eroxa090/SoilPlus2.0/public/soilplus-device.jpg

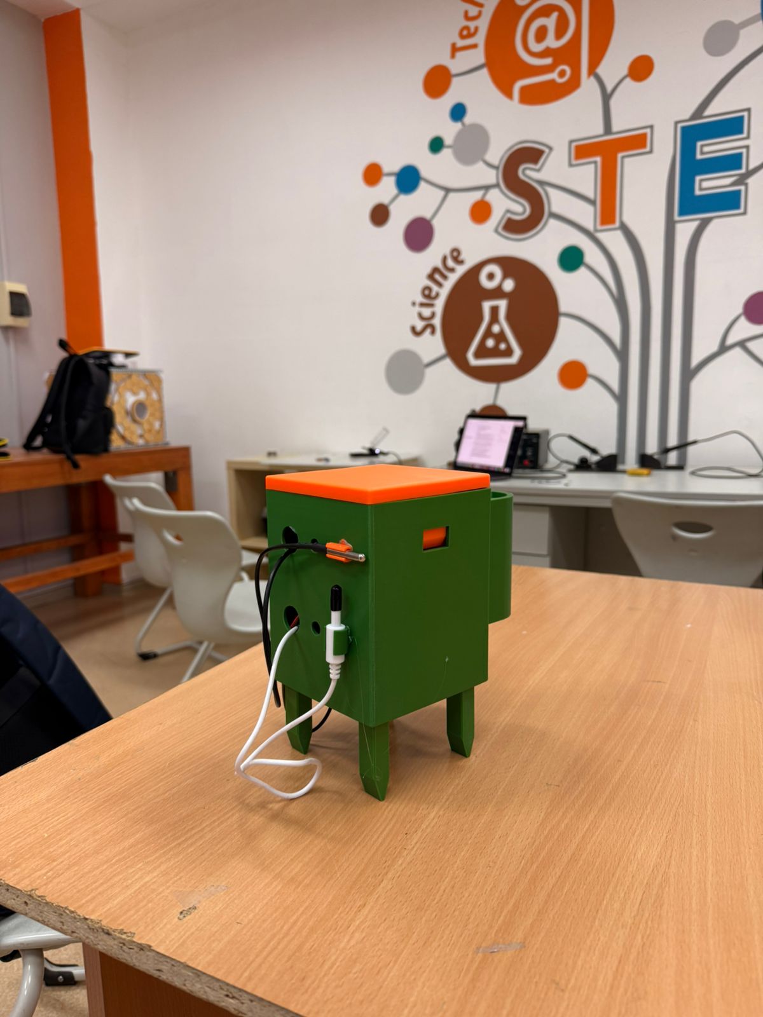
public/soilplus-device.jpg
