eroxa090/SoilPlus2.0/hardware/probe_mini/README.md

# SoilPlus Mini — короткий ручной щуп

Высота 27 см. Блок 95×95×48 мм, Т-ручка, горловина с юбкой-упором 120×70 мм.
Влажность уходит в почву на ~7 см, DS18B20 на 5 см, иглы TDS на 1.2 см. Электрод pH внешний, на разъёме BNC.

## Как запустить в Fusion

1. New Design → **Hybrid Design**, единицы mm.
2. UTILITIES → **Scripts and Add-Ins** → «+» → *Script or add-in from device* → папка `hardware/probe_mini/SoilPlusMini` → **Run**.
3. Результаты появятся в `hardware/probe_mini/out/`: STEP, STL, снимки и `fusion_report.json`.

Размеры — в блоке «ПАРАМЕТРЫ» и в функциях `build_*` файла `SoilPlusMini.py`.

## Детали для печати (PETG, слой 0.2, 6 периметров, без поддержек)

| Файл | Как класть на стол | Заполнение |
|---|---|---|
| 0_Test_Fit — тест пазов под перфоплату (печатать первым) | как есть | 25 % |
| 1_Body — блок | задней стенкой вниз, проём вверх | 25 % |
| 2_Lid — крышка | надписью вниз | 25 % |
| 3_Deck — панель | гладкой стороной вниз, направляющие вверх | 25 % |
| 10_Back_Frame — прижимная рамка | гладкой стороной вниз, упоры вверх | 30 % |
| 4_Handle — Т-ручка | боковой плоскостью вниз | 40 % |
| 5_Sensor_Head — горловина с юбкой | юбкой вниз | 30 % |
| 6_Blade_Guard — защитная вилка | плашмя | 100 % |
| 8a_Clamp_Center, 8b_Clamp_DS, 8c_Clamp_TDS — губки зажима | ровной стороной вниз | 100 % |
| 11_DS_Guard — мини-штатив DS18B20 | стоя, кольцом вниз, кайма 5 мм | 100 % |
| 12_Electrode_Cap_Holder — нижний держатель электрода (за колпачок) | стоя, основанием вниз | 100 % |
| 13_Electrode_Clip — верхняя клипса электрода | стоя, основанием вниз | 100 % |
| 7_Cap — колпачок | дном вниз | 15 % |
| 16_Plug_TypeC_Charge, 17_Plug_TypeC_ESP32 — заглушки Type-C | фланцем вниз | 100 % |

## Крепёж и инструмент

| Что | Кол-во | Куда |
|---|---|---|
| Винт M3×8 **с шестигранником (DIN 912)** | 8 | ручка (4), горловина (4), изнутри блока |
| Винт M3×10 | 12 | крышка (4), панель с рамкой (4), держатели электрода (4) |
| Винт M3×16 | 4 | губки зажима, сзади через отверстия горловины |
| Кусочки филамента 1.75 мм | 3 | штифт BMP280 (~3 см), центровка рамки (2 шт. по 4 мм) |

Латунных вставок нет: винты M3 вкручиваются прямо в пластик, в отверстия Ø2.5 (`PILOT_D`), и сами нарезают резьбу. Первый раз вкручивай медленно, до лёгкого упора, не перетягивай. Такая резьба выдерживает 3–5 разборок. Если отверстие разболталось, поставь винт на 2 мм длиннее или переходи на латунные вставки M3: тогда `PILOT_D = 4.0`.

Нужен Г-образный шестигранный ключ 2.5 мм: винты ручки и горловины стоят внутри блока, обычная отвёртка туда не войдёт. Для зажима — отвёртка с тонким стержнем (отверстия Ø7).

## Размеры

Зазор посадки везде 0.3 мм на сторону (`CLR` в начале скрипта). Исключения: зажимы, прижимы и штифты — они сделаны в натяг, иначе детали болтались бы.

| Деталь | Размер | Откуда |
|---|---|---|
| Плата pH | 41 × 32, с BNC 61 | замер |
| Электрод pH | Ø18.5, колпачок Ø21.5 × 51.5, длина 185 | замер |
| Плата TDS / щуп | 42 × 32 / корпус 44, иглы 6, кабель Ø3.5 | замер |
| Диаметр щупа TDS | ~12, губка на шарнире зажмёт Ø11.7–13.2 | в паспорте нет |
| DS18B20 | Ø6 × 51, кабель Ø4 | замер |
| Датчик влажности | 98.5 × 23 × 1, детали 9 | замер |
| ESP32 | 52 × 28, Type-C выступает 1.5, ряды 25.4 | замер / DevKit 30 pin |
| TP4056 | 28.5 с Type-C | замер |
| MT3608 | 37 × 17.5 × 6.5 | замер |
| BMP280 | 15 × 11 | замер |
| Аккумулятор 103450 | 52 × 34.5 × 10 с платой защиты | продавцы |
| Тумблер KCD1 2 pin | корпус 19 × 13 | продавцы |
| Перфоплата | 50 × 70 | стандарт 5×7 см |
| Пазы под платы (перфоплата, pH, TDS) | 1.8 (`PCB_SLOT`) | тест 0_Test_Fit: туго в 1.7, в 1.8+ болтается; в панели паз лежит поперёк слоёв, 1.8 = 9 слоёв |

Если реальная деталь отличается — поменять число в начале `SoilPlusMini.py` (`BAT_L`, `BAT_W`, `TDS_D`, `BNC_Z`, `BNC_Y`, `ELECTRODE_*`) и запустить скрипт заново.

## Как что закреплено

| Что | Чем держится |
|---|---|
| Ручка | 4 винта M3×8 изнутри блока у боковых стенок, в отверстия в широком основании ручки |
| Горловина | 4 винта M3×8 изнутри блока вниз, в отверстия в колоннах. Штырёк-ключ не даст поставить её наоборот |
| Крышка | 4 винта M3×10 через ушки. Рёбра жёсткости изнутри. Выступ BNC не даст закрыть её перевёрнутой |
| Панель и рамка | 4 винта M3×10 на 4 стойки; 2 штифта из филамента держат рамку на панели при сборке |
| pH-4502C, TDS | Едут в пазах панели до центрального упора; снаружи запирает стенка корпуса |
| Перфоплата с ESP32 | Едет в пазах до упора; запирает стойка на крышке. ESP32 прижимает подушка на крышке |
| TP4056, MT3608 | В гнёздах с упорами на задней стенке; прижаты по кромке упорами рамки |
| Аккумулятор | В гнезде с вырезом под провода слева; прижат двумя пружинящими лапками рамки |
| Тумблер KCD1 | Защёлкивается в окно стенки своими лапками |
| BMP280 | В пазах кармана до упора; снизу запирает штифт из филамента |
| Электрод pH (Ø18.5, колпачок Ø21.5) | Колпачок стоит на юбке в нижнем держателе на горловине, корпус защёлкивается в верхнюю клипсу на задней стенке блока |

Клей и скотч нигде не нужны.

## Датчики в горловине

Подвижная половина зажима разделена на 3 губки со своими винтами, поэтому каждая прижимает свой датчик.

- **Влажность:** плата заперта внутри вилки: снизу перемычка, сверху зубья. Плату ничего не сжимает.
- **Вилка:** её ушки лежат на дне и зажаты центральной губкой, винты проходят сквозь ушки.
- **DS18B20:** гильза в мини-штативе, буртик штатива между дном и зажимом, кабель зажат левой губкой.
- **Щуп TDS:** зажат за корпус правой губкой (шарнир + 1 винт).

## Порядок сборки

1. Напечатать 0_Test_Fit, проверить пазы под перфоплату.
2. Вставить плату влажности в вилку (электронику покрыть лаком), вилку опустить сверху в щель дна.
3. DS18B20 вставить в штатив кабелем вперёд, штатив опустить сверху в отверстие дна. Щуп TDS сверху (низ корпуса вровень с дном).
4. Поставить 3 губки зажима, затянуть 4 винта M3×16 через отверстия сзади.
5. Кабели DS18B20 и TDS укоротить до ~25 см и обжать в JST.
6. Блок, пока внутри пусто: привинтить ручку и горловину ключом изнутри (протянуть кабели в отверстие дна).
7. Задний ярус: MT3608 выставить на 5.0 В, поставить MT3608, TP4056, аккумулятор, тумблер. Провода к панели — через JST, пометить разъёмы.
8. На панель: pH справа и TDS слева в пазы до центрального упора. ESP32 паять на перфоплату по реальной сетке, Type-C к левому краю, перфоплату задвинуть справа до упора.
9. Рамку совместить с панелью штифтами, опустить в блок (BNC входит в паз справа), затянуть 4 винта. BMP280 вставить снизу в карман, запереть штифтом.
10. Подключить разъёмы, закрыть крышку на 4 винта.

**Прошивка:** кнопки EN и BOOT на ESP32 нажимаются зубочисткой через две прорези на крышке у левого края.
**BNC:** заглушку для разъёма лучше купить готовую (защитный колпачок BNC).

 ножом или отвёрткой сделать щель и отверстие под DS18B20, поставить щуп до упора юбкой, прижать землю вокруг.
Сила упирается в ручку и юбку: не качай прибор, когда он в земле.
Датчик влажности калибровать уже в собранном виде: `cal moistdry` / `cal moistwet`.
