eroxa090/SoilPlus2.0/hardware/probe/README.md

# SoilPlus — ручной щуп (модель для Fusion)

## Как запустить

1. Fusion → **Shift+S** (Scripts and Add-Ins).
2. Нажать **«+»** → *Script or add-in from device* → выбрать папку `hardware/probe/SoilPlusProbe`.
3. Выбрать **SoilPlusProbe** → **Run**. Скрипт работает 2–5 минут и откроет новый документ.
4. В конце появится окно с числом ошибок и пересечений. Результаты лежат в `hardware/probe/out/`:
   - `SoilPlus_Probe.step` — вся сборка;
   - `*.stl` — детали для печати;
   - `*.png` — снимки;
   - `fusion_report.json` — отчёт.

Если macOS спросит, можно ли Fusion писать в папку «Рабочий стол», — разрешить.

Размеры меняются в начале `SoilPlusProbe.py` (блок «ПАРАМЕТРЫ») → снова Run.

## Детали для печати (PETG, слой 0.2, 6 периметров)

| Деталь | Как класть на стол | Заполнение | Поддержки |
|---|---|---|---|
| 0_Test_Fit — тест вставок и трубы | как есть | 25 % | нет |
| 1_Head_Shell — корпус блока | дном (где окна портов) вниз | 25 % | tree, авто |
| 2_Head_Lid — крышка | надписью вниз | 25 % | нет |
| 3_Stirrup_Front / Back — стремя | плоскостью разреза вниз (176×176) | **40 %** | нет |
| 4_Nose — наконечник | шейкой вниз, остриём вверх, кайма 5 мм | **40 %** | нет |
| 6_Handle_Front / Back — Т-ручка | плоскостью разреза вниз | 30 % | нет |
| 7_Tube_Clamp — обойма | ровной задней стороной вниз (желоб вверх) | 30 % | нет |
| 8_Mount_Plate — монтажная плата | стоя на нижнем торце, кайма 5 мм | 25 % | tree, авто |

Стремя и наконечник — 40 %: на них давят ногой.

## Купить

| Что | Кол-во |
|---|---|
| Труба алюминиевая 25×2 мм, 770 мм (или ПВХ 25) | 1 |
| Полоса алюминиевая 40×4 мм, 118 мм (ступенька) | 1 |
| Вставки латунные M3 (отв. Ø4.0, длина ≤ 8) | 23 |
| Винт M3×16 | 15 |
| Винт M3×10 (крышка) | 4 |
| Винт M3×8 (монтажная плата) | 4 |
| Винт M3×40 + гайка (наконечник) | 1 |
| Винт M3×45 + гайка (стремя и ручка к трубе) | 2 |
| Шнур уплотнительный Ø2 | 50 см |
| Трубка силиконовая 6×8 мм | ~1.5 м (от насоса до наконечника) |

## Сверлить трубу

- Ø3.4 поперёк трубы: в 43 мм от нижнего конца и в 22 мм от верхнего.
- Ø10 со стороны крышки блока: в 568 мм от нижнего конца. Через это отверстие провода выходят в блок, поставить резиновую втулку.

## Как идут вода и провода

Трубка 6×8 заходит в отверстие на верху Т-ручки, идёт внутри штанги и через канал в правой ноге стремени попадает в наконечник. Вода выходит на скосе острия, ниже датчиков.
Провода датчиков идут тем же путём вверх и выходят в блок через отверстие Ø10.

## Что проверить, когда придут детали

- ESP32: разъём Type-C должен стоять на нижнем краю перфоплаты, иначе он не попадёт в окно дна.
- pH-4502C: BNC внизу платы, по центру. Если стоит иначе — сдвинуть окно (`bnc` в `build_shell`).
- Щуп TDS: диаметр Ø12 и длина корпуса ~45 мм взяты на глаз.
- Датчик влажности v1.2 закрыт стенкой 0.8 мм. После сборки откалибровать прямо в корпусе: `cal moistdry` / `cal moistwet`.
