eroxa090/SoilPlus2.0/hardware/enclosure/viewer_template.html

# SoilPlus колышек

Голова с выдвижным двухъярусным лотком, ствол из двух половин и игла для глубокого полива. Серым и цветным показаны макеты модулей: по ним проверены зазоры.

голова 132×98×64 мм

глубина 10 см

деталей 6

стол ≤180 мм

поддержки нет

Загружаю модель…

Собрано Разнесено Лоток выдвинут Сквозь корпус

Модули Почва Разрез

Вращать — левой кнопкой или пальцем, двигать — правой, масштаб — колесом. Наведи на деталь, чтобы увидеть название.

## Печать — 6 деталей, PETG

Слой 0.2, стенки 6 периметров (2.4 мм), заполнение 25–30 %. Все детали без поддержек, если класть их так, как написано серым.

## Крепёж

Вставки M3 (отв. Ø4.0, глуб. 6) | 16 шт
M3×8, полукруглая головкапередняя панель → фланец головы | 4 шт
M3×8, потайпалуба → стойки лотка | 4 шт
M3×6, потайколышек → голова, изнутри | 4 шт
M3×16, любая головкаполовины колышка | 4 шт
Штифт Ø3×8 (гвоздь, пруток)центровка половин колышка | 3 шт
Шнур уплотнителя Ø2канавка на панели, П-образно | ~30 см

Потайные M3 и шнур Ø2 добавь в список покупок, если их нет.

## Сборка

1. Вплавь все вставки паяльником (~220 °C) до установки электроники.
2. Колышек: датчик влажности (электронику покрыть лаком) в щель, DS18B20 и щуп TDS в отверстия дна, иглу с трубкой в гнездо. Кабели вверх. Закрой половины, 4 винта, низ промажь силиконом.
3. Прикрути колышек к голове: 4 потайных винта изнутри.
4. Ярус 1 на столе: аккумулятор на стяжку, TP4056, тумблер в панель, два MT3608 (сначала выставь 5.0 В), D4184, конденсатор.
5. Палуба: перфоплата с ESP32 въезжает сзади в направляющие до упора. pH-плата — BNC в отверстие панели. TDS-плата сзади справа. Провода через прорези, палубу на 4 винта.
6. В кабельном отсеке подключи JST датчиков и BMP280, задвинь лоток, затяни 4 винта панели.

## Размеры взяты типовые — проверь, когда придут детали

- ESP32 51.5×28.5: разъём Type-C должен оказаться на переднем краю перфоплаты, иначе он не совпадёт с окном панели. Гребёнки паяй так, чтобы плата ESP32 выступала вперёд на ~0.7 мм.
- D4184 заложен самый большой вариант (35×16). Если придёт маленький (23×16), он просто встанет в гнездо с запасом.
- Тумблер KCD1: вырез 19.2×13.2. Бывают 21×15 — тогда поменяй одно число в скрипте.
- Щуп TDS: диаметр в паспортах не указан, заложено Ø12. Если другой, меняется одно число.
- Трубка 6×8 мм под ёлочку иглы. Сначала купи насос, потом трубку под его штуцер.
