eroxa090/SoilPlus2.0/hardware/probe/out/1_iso.png

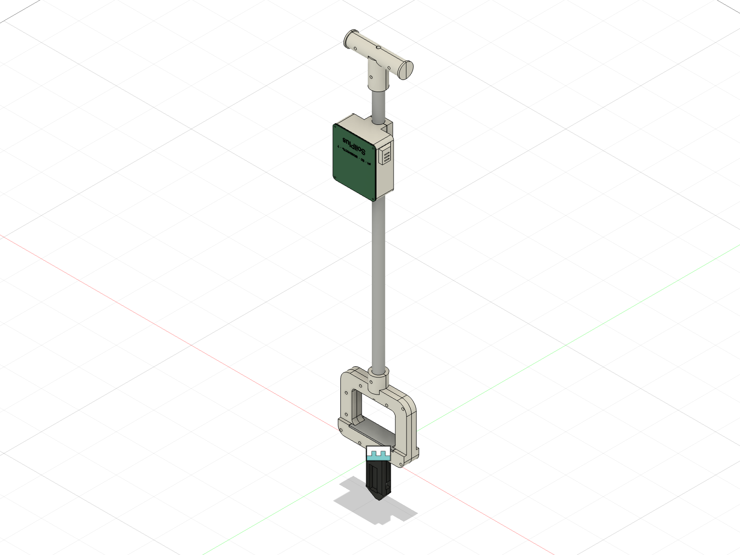
hardware/probe/out/1_iso.png
