eroxa090/SoilPlus2.0/hardware/probe/out/3_head_open.png

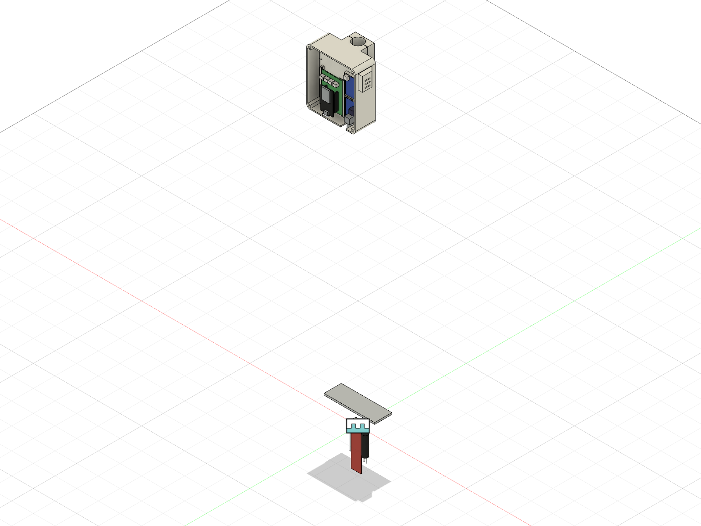
hardware/probe/out/3_head_open.png
