eroxa090/SoilPlus2.0/hardware/probe/out/6_stirrup_nose.png

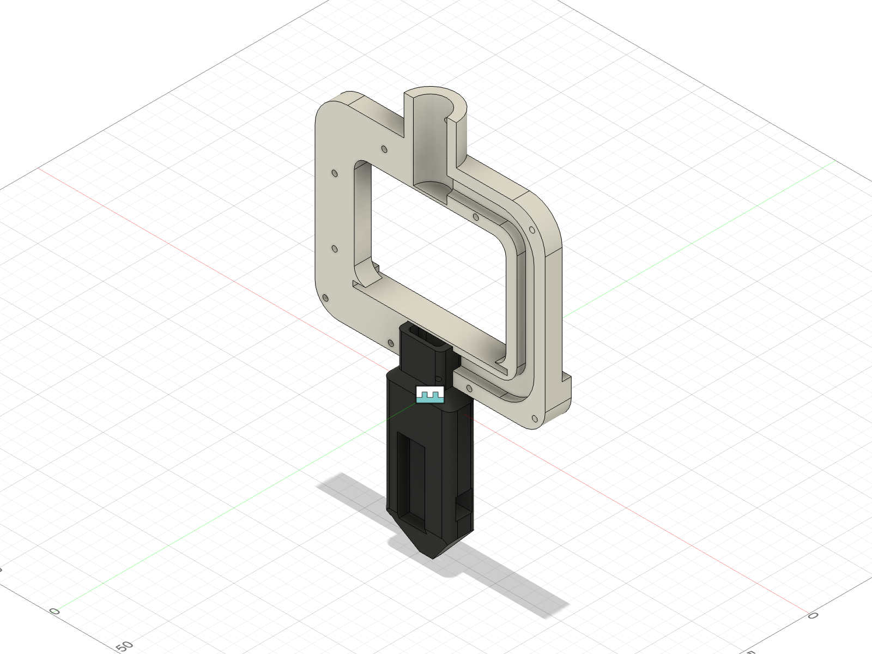
hardware/probe/out/6_stirrup_nose.png
