eroxa090/SoilPlus2.0/hardware/probe/out/7_nose_iso.png

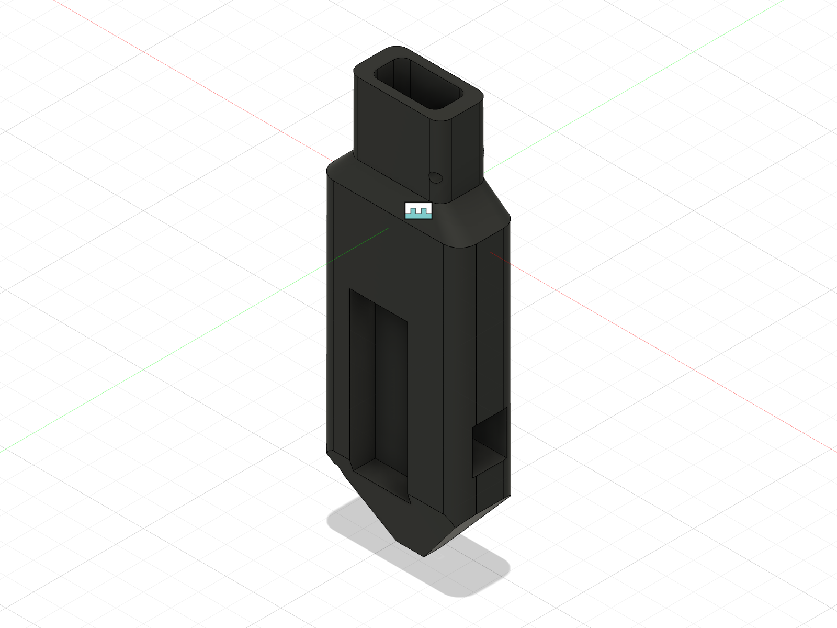
hardware/probe/out/7_nose_iso.png
