eroxa090/SoilPlus2.0/hardware/probe/out/8_handle.png

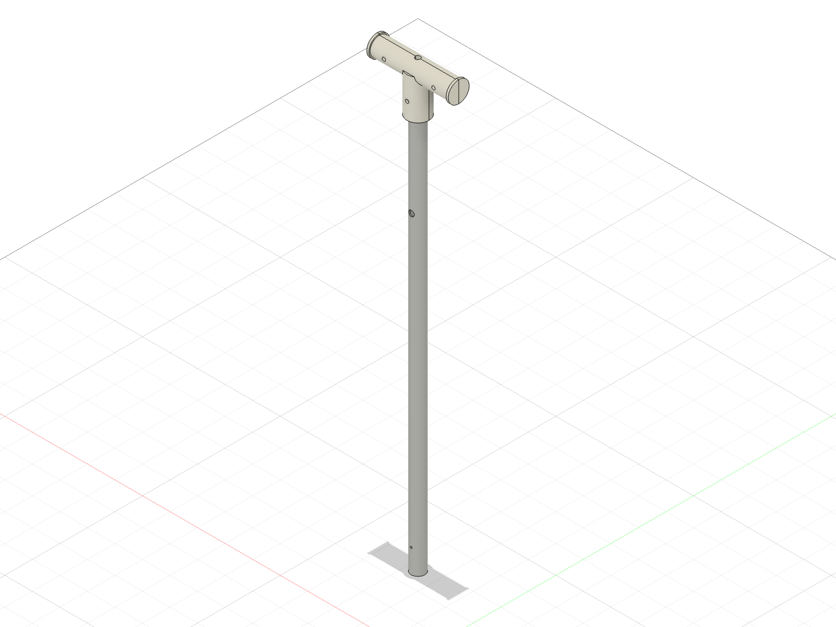
hardware/probe/out/8_handle.png
