eroxa090/SoilPlus2.0/hardware/probe_mini/out/1_iso.png

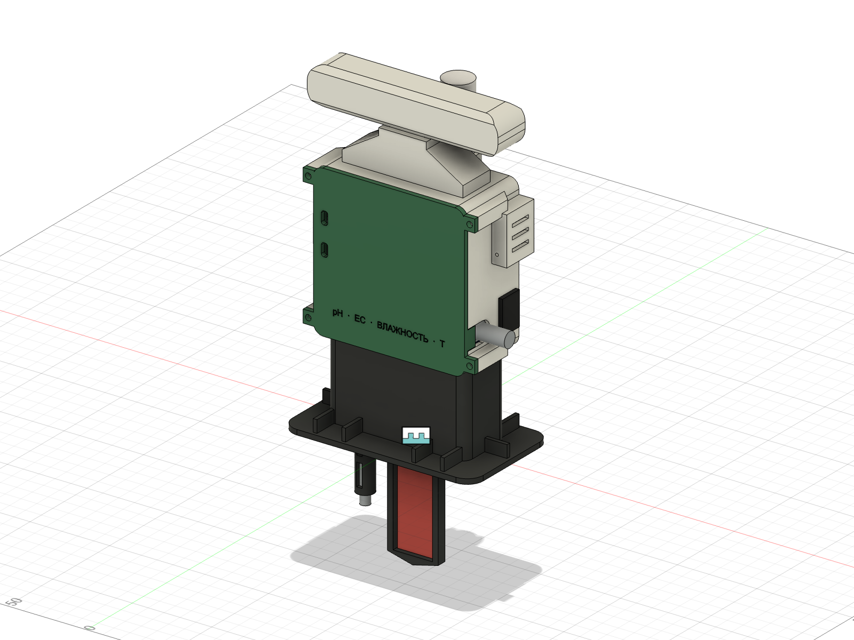
hardware/probe_mini/out/1_iso.png
