eroxa090/SoilPlus2.0/hardware/probe_mini/out/2_front.png

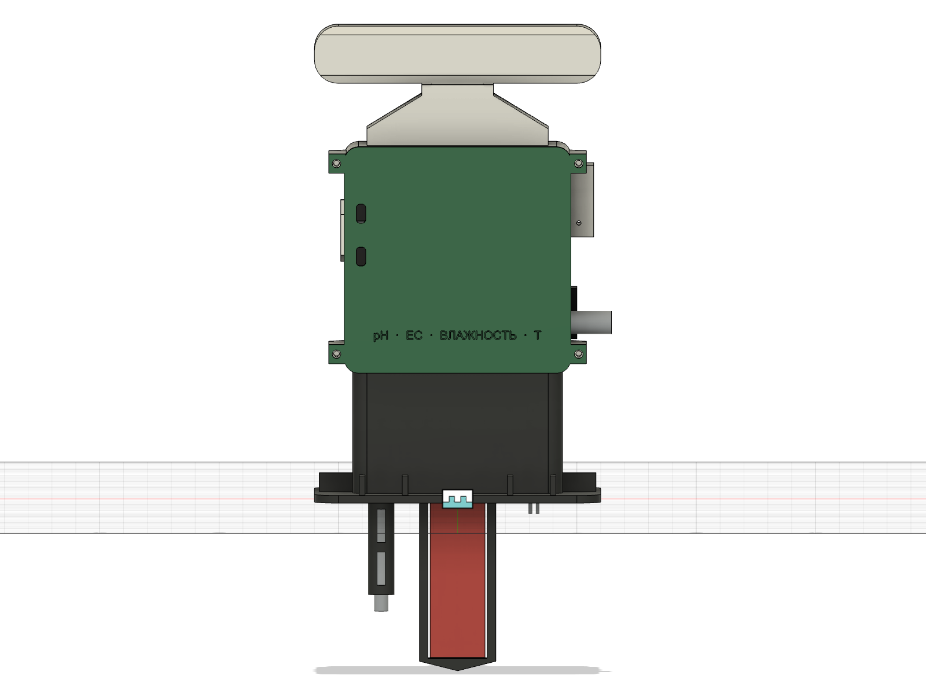
hardware/probe_mini/out/2_front.png
