eroxa090/SoilPlus2.0/hardware/probe_mini/out/4_no_deck.png

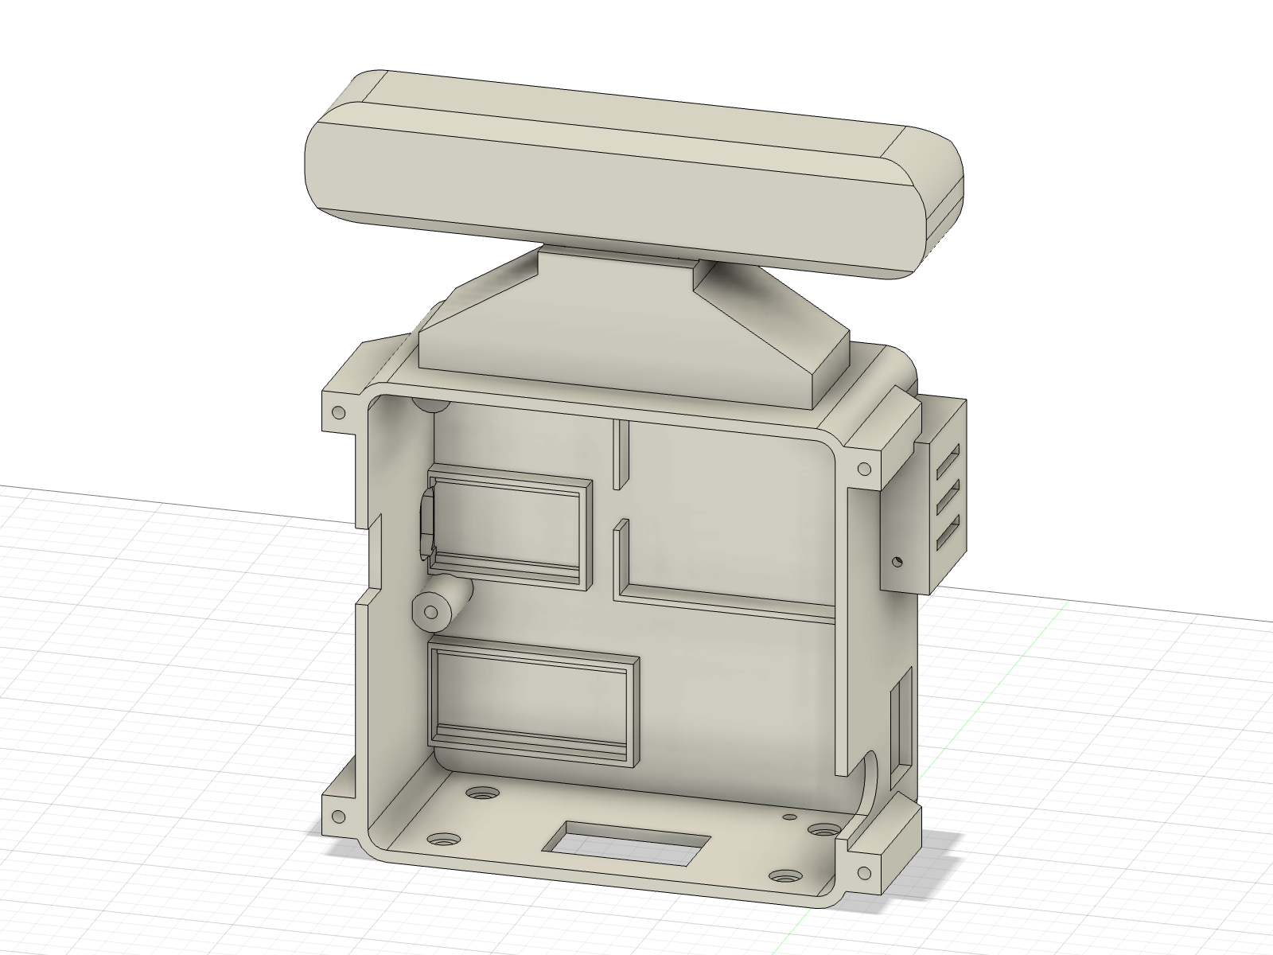
hardware/probe_mini/out/4_no_deck.png
