eroxa090/SoilPlus2.0/hardware/probe_mini/out/5_bottom.png

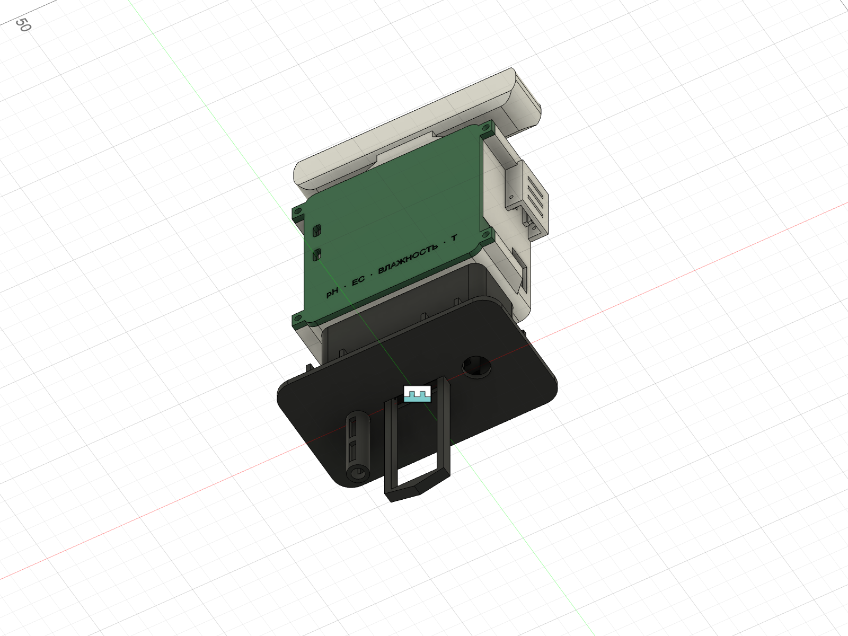
hardware/probe_mini/out/5_bottom.png
