eroxa090/SoilPlus2.0/hardware/probe_mini/out/6_left_ports.png

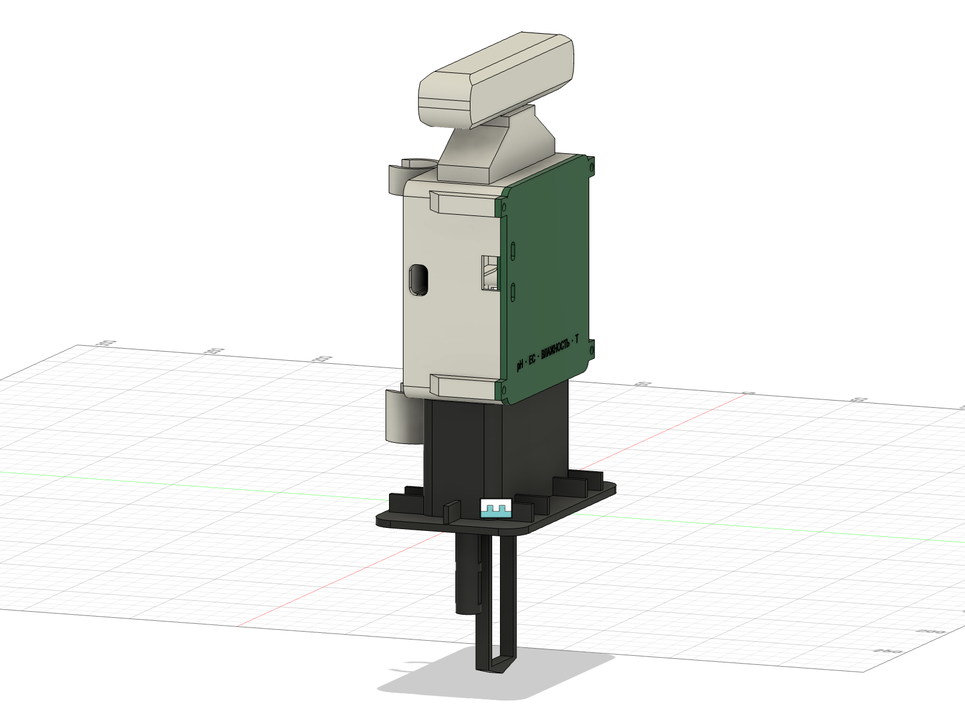
hardware/probe_mini/out/6_left_ports.png
