eroxa090/SoilPlus2.0/hardware/probe_mini/out/7_right_ports.png

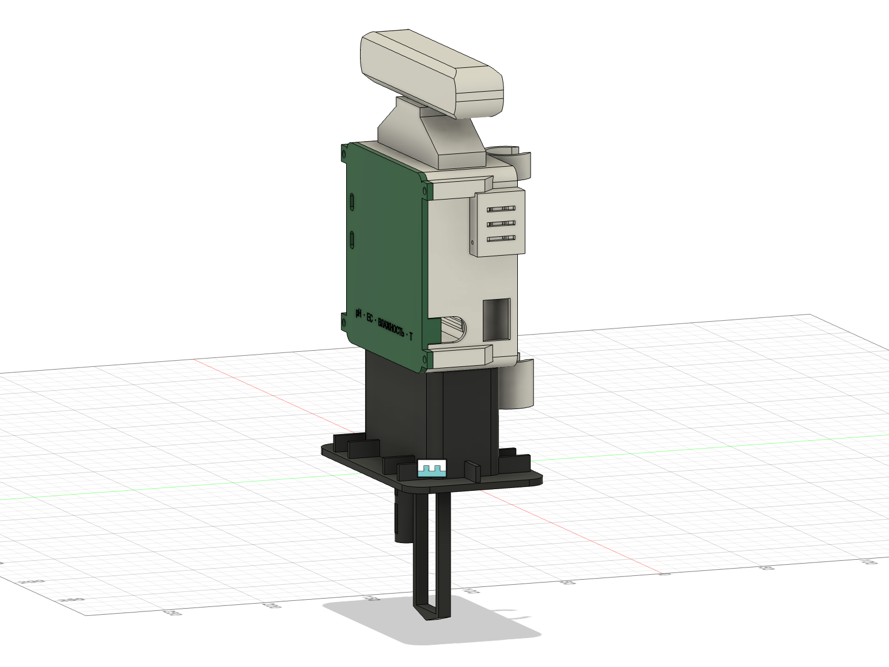
hardware/probe_mini/out/7_right_ports.png
