eroxa090/SoilPlus2.0/hardware/probe_mini/out/8_cap.png

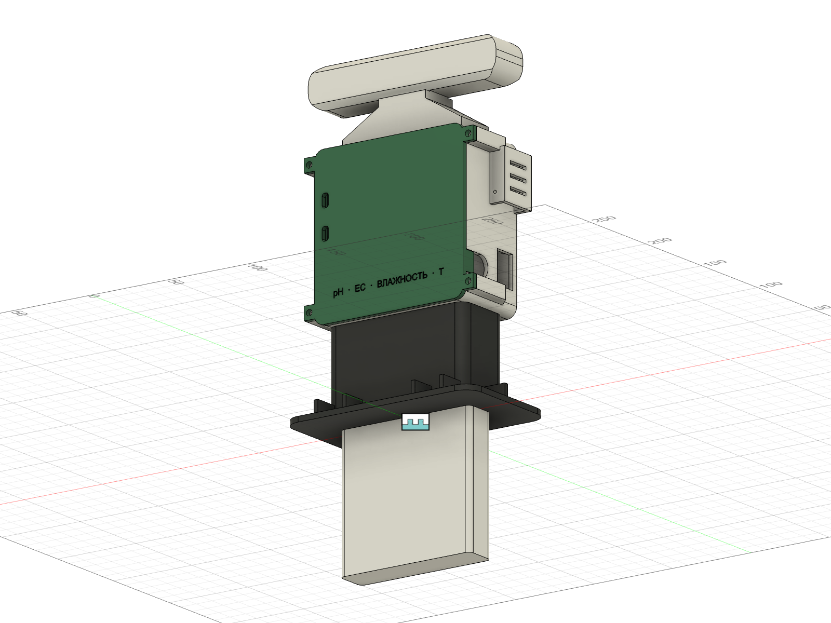
hardware/probe_mini/out/8_cap.png
