eroxa090/SoilPlus2.0/hardware/probe/out/2_Head_Lid.stl

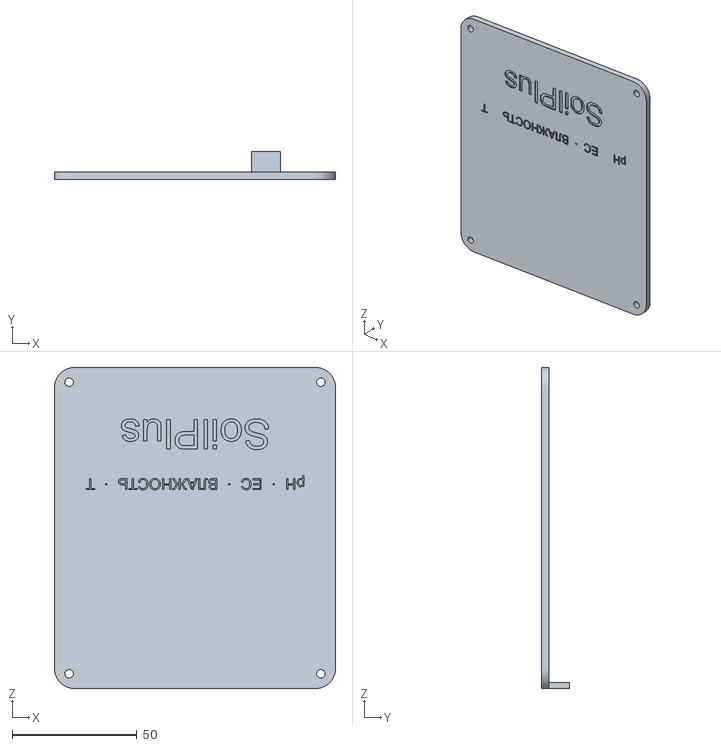
[picture p14: CAD file, 2026-11-07]
hardware/probe/out/2_Head_Lid.stl
112.8 x 11.2 x 128.8
