eroxa090/SoilPlus2.0/hardware/probe_mini/out/5_Sensor_Head.stl

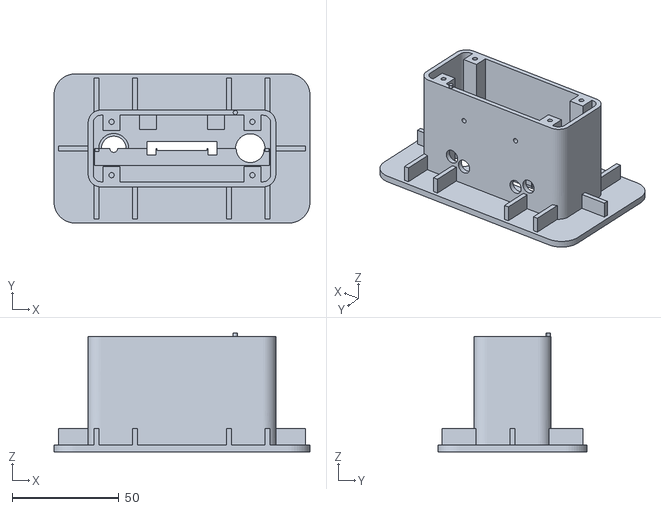
[picture p15: CAD file, 2026-11-12]
hardware/probe_mini/out/5_Sensor_Head.stl
120.0 x 70.0 x 55.6
