eroxa090/SoilPlus2.0/hardware/probe/out/3_Stirrup_Front.stl

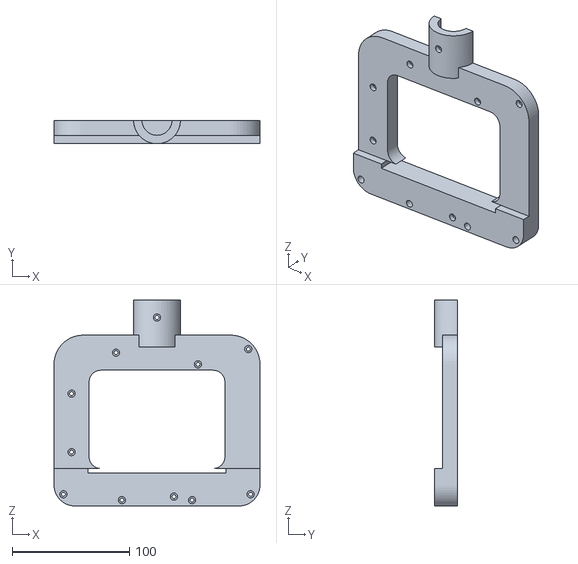
[picture p16: CAD file, 2026-11-07]
hardware/probe/out/3_Stirrup_Front.stl
176.0 x 20.0 x 176.0
