eroxa090/SoilPlus2.0/hardware/probe_mini/out/3_Deck.stl

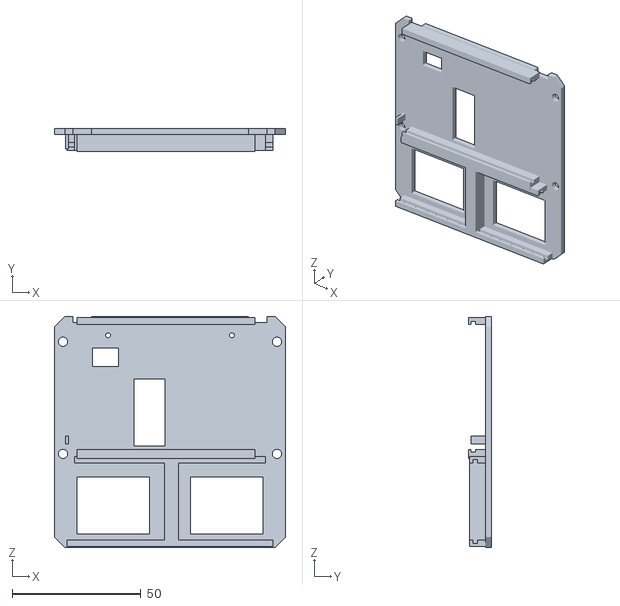
[picture p17: CAD file, 2026-11-12]
hardware/probe_mini/out/3_Deck.stl
89.6 x 9.00 x 89.6
