eroxa090/SoilPlus2.0/hardware/probe/out/7_Tube_Clamp.stl

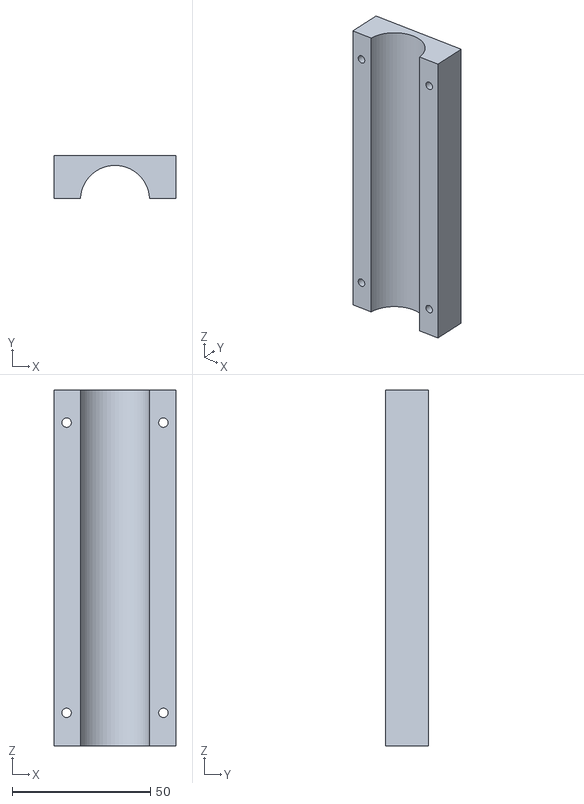
[picture p18: CAD file, 2026-11-07]
hardware/probe/out/7_Tube_Clamp.stl
44.0 x 15.4 x 128.8
