eroxa090/SoilPlus2.0/hardware/probe_mini/out/4_Handle.stl

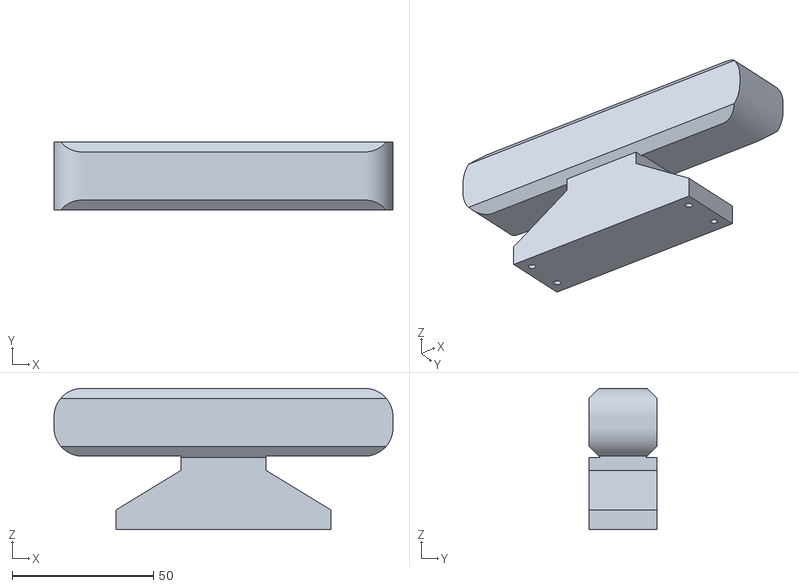
[picture p19: CAD file, 2026-11-12]
hardware/probe_mini/out/4_Handle.stl
120.0 x 24.0 x 50.0
