eroxa090/SoilPlus2.0/hardware/probe/out/6_Handle_Back.stl

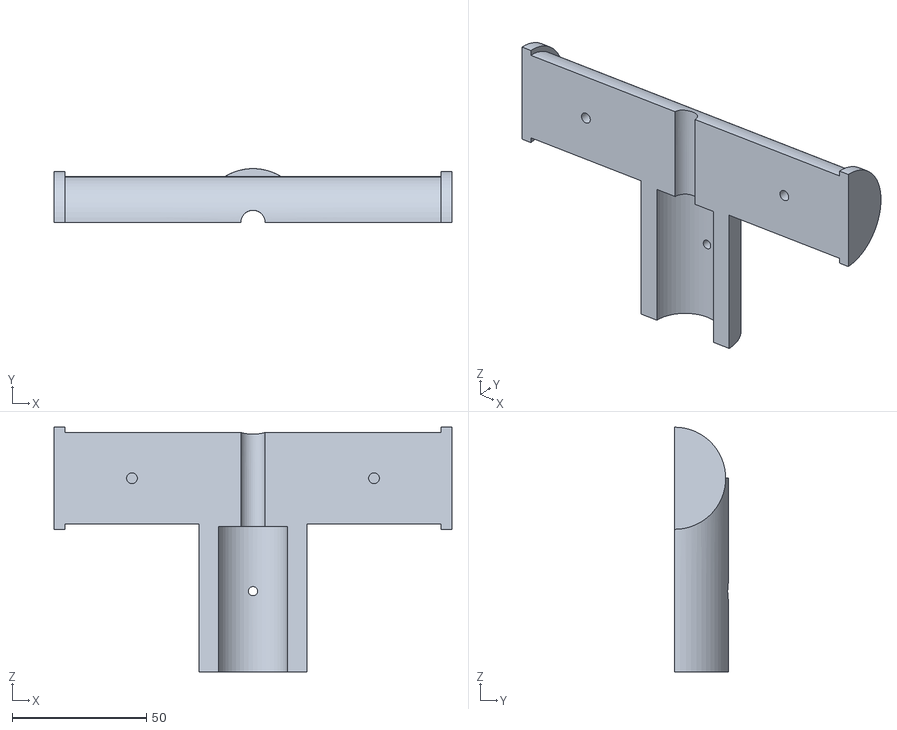
[picture p20: CAD file, 2026-11-07]
hardware/probe/out/6_Handle_Back.stl
148.0 x 20.0 x 91.0
