eroxa090/SoilPlus2.0/hardware/probe_mini/out/SoilPlus_Probe.step

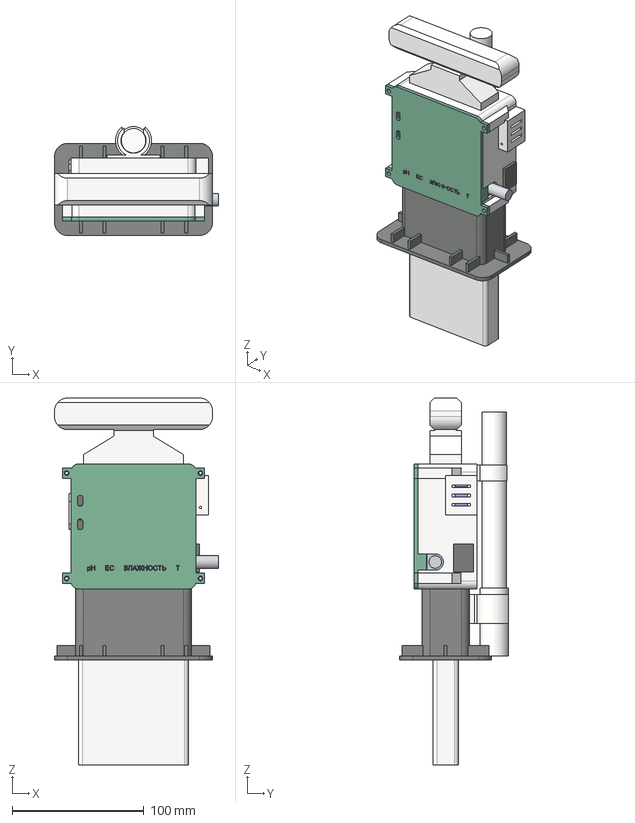
[picture p21: CAD file, 2026-11-12]
hardware/probe_mini/out/SoilPlus_Probe.step
124.5 x 82.7 x 278.6 mm
