eroxa090/SoilPlus2.0/hardware/probe/out/SoilPlus_Probe.step

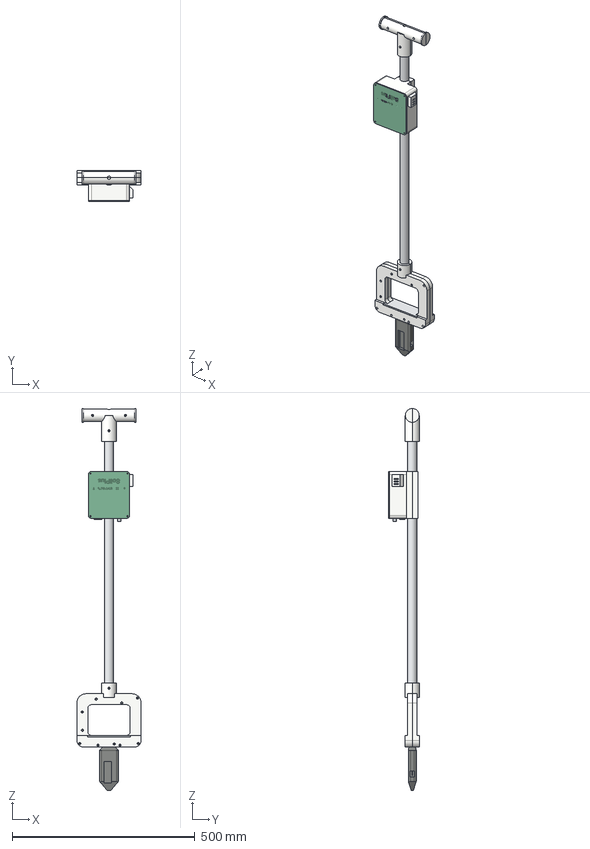
[picture p22: CAD file, 2026-11-07]
hardware/probe/out/SoilPlus_Probe.step
176.0 x 85.4 x 1046.0 mm
