eroxa090/SoilPlus2.0/hardware/probe_mini/out/1_Body.stl

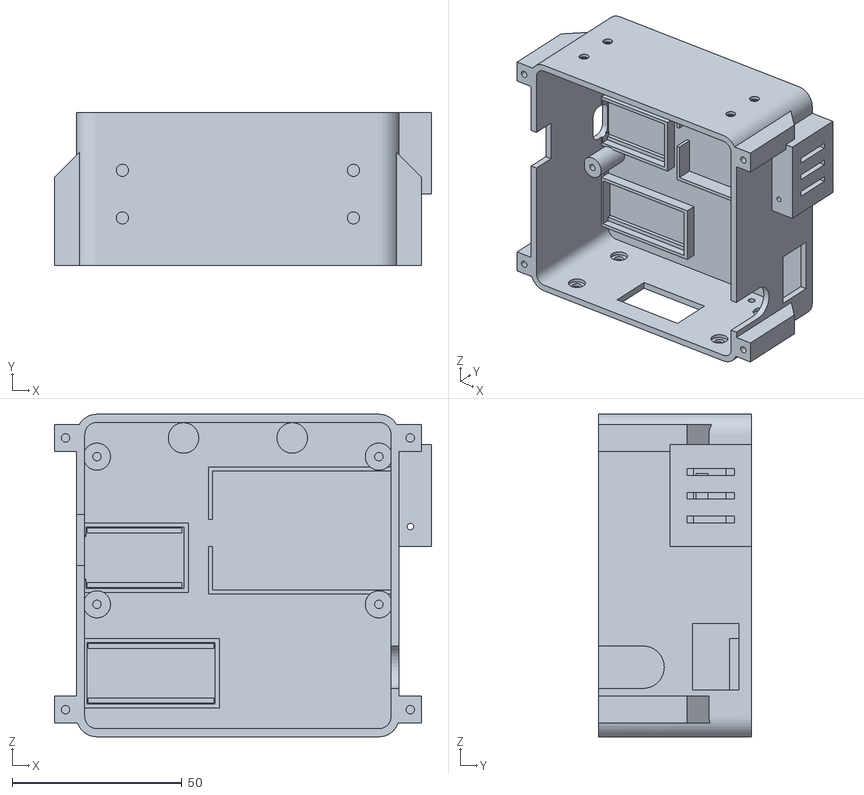
[picture p23: CAD file, 2026-11-12]
hardware/probe_mini/out/1_Body.stl
111.0 x 45.0 x 95.0
