eroxa090/SoilPlus2.0/hardware/probe/out/1_Head_Shell.stl

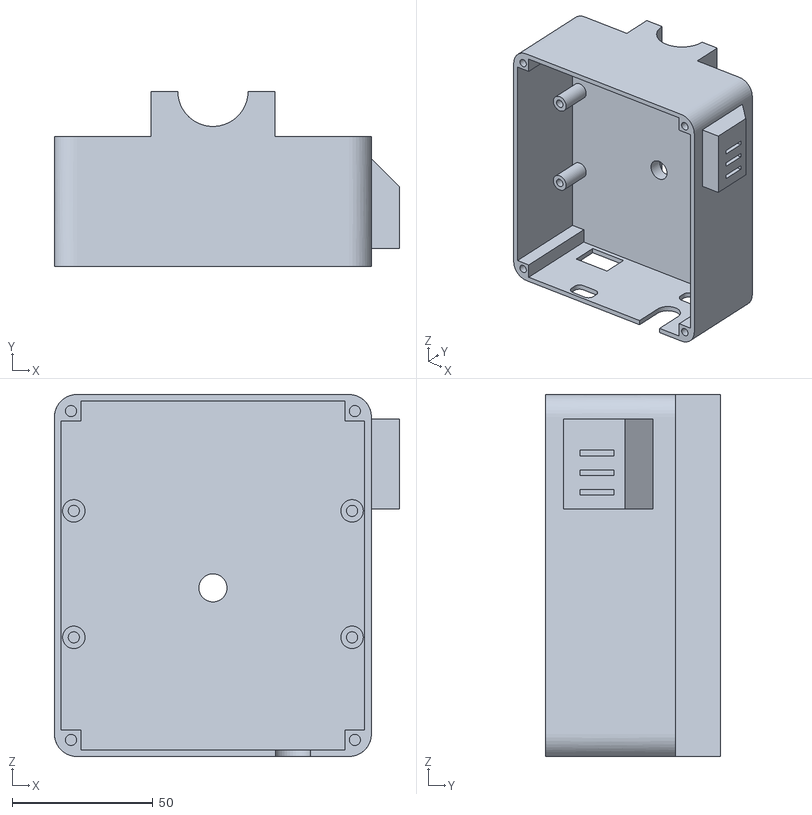
[picture p24: CAD file, 2026-11-07]
hardware/probe/out/1_Head_Shell.stl
122.8 x 62.4 x 128.8
