eroxa090/SoilPlus2.0/hardware/probe_mini/out/17_Plug_TypeC_ESP32.stl

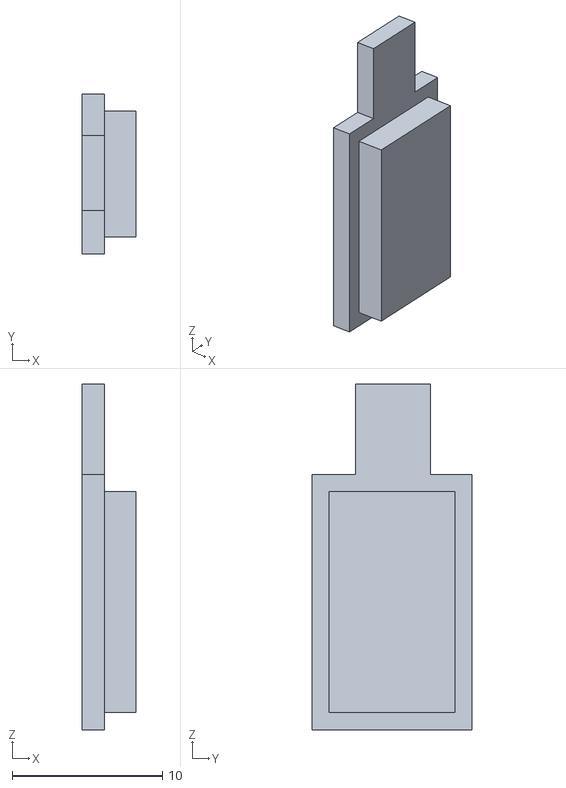
[picture p25: CAD file, 2026-11-12]
hardware/probe_mini/out/17_Plug_TypeC_ESP32.stl
3.60 x 10.6 x 23.0
