eroxa090/SoilPlus2.0/hardware/probe/out/0_Test_Fit.stl

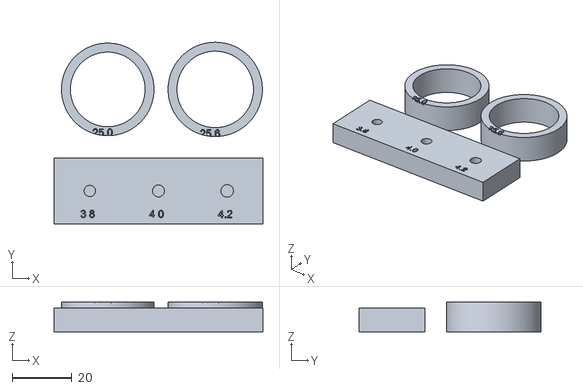
[picture p26: CAD file, 2026-11-07]
hardware/probe/out/0_Test_Fit.stl
70.0 x 60.8 x 10.0
