eroxa090/SoilPlus2.0/hardware/probe_mini/out/0_Test_Fit.stl

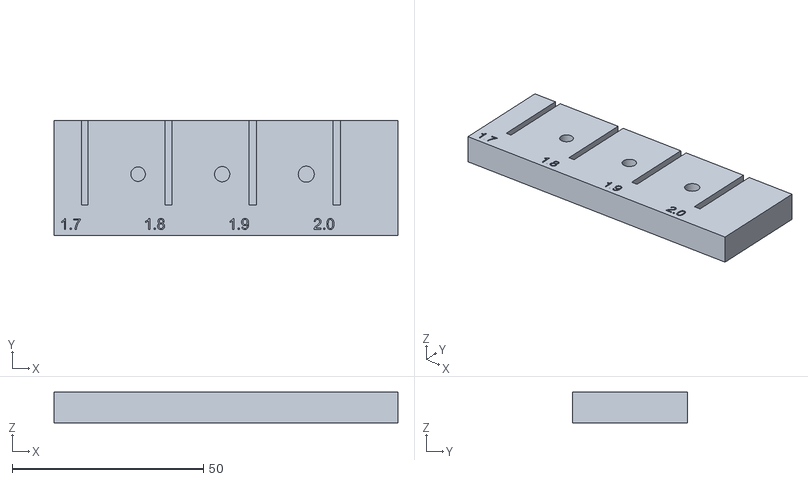
[picture p27: CAD file, 2026-11-12]
hardware/probe_mini/out/0_Test_Fit.stl
90.0 x 30.0 x 8.00
