eroxa090/SoilPlus2.0/hardware/probe/out/4_Nose.stl

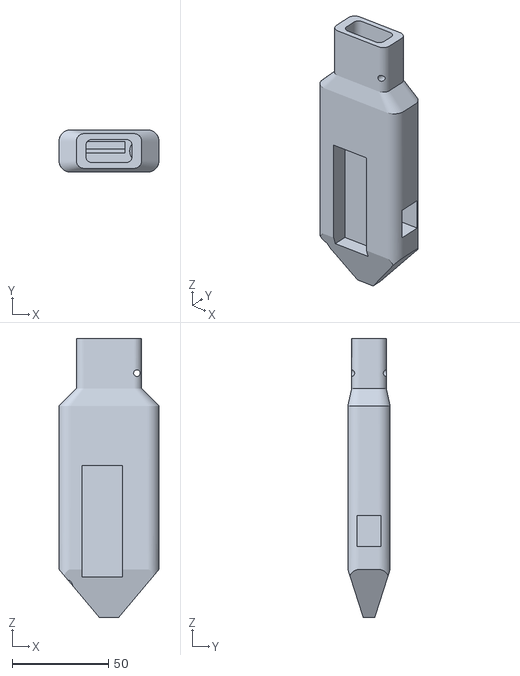
[picture p28: CAD file, 2026-11-07]
hardware/probe/out/4_Nose.stl
52.0 x 22.0 x 145.0
