eroxa090/SoilPlus2.0/hardware/probe_mini/out/7_Cap.stl

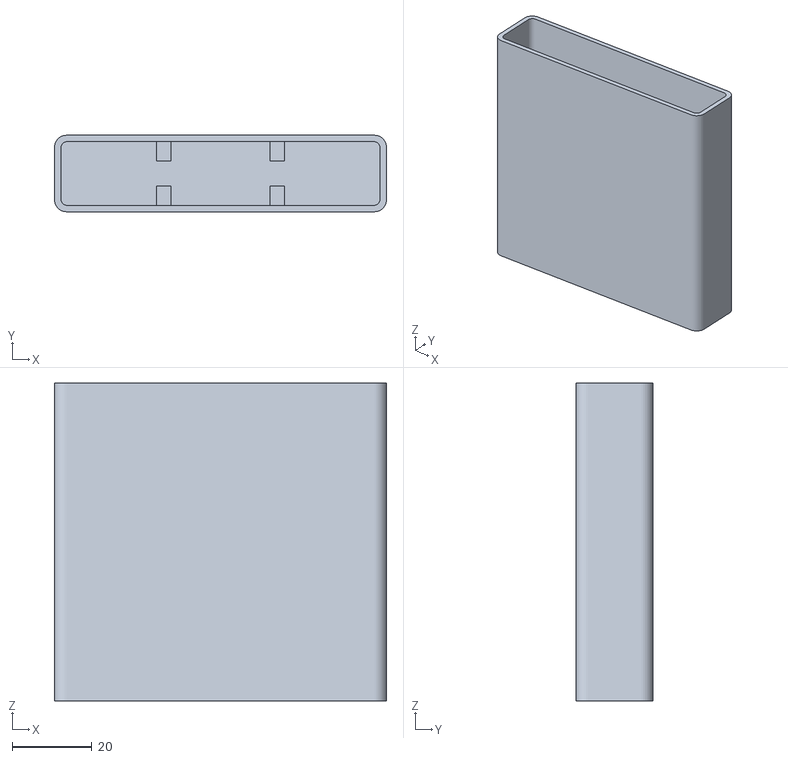
[picture p29: CAD file, 2026-11-12]
hardware/probe_mini/out/7_Cap.stl
83.2 x 19.2 x 79.6
