eroxa090/SoilPlus2.0/hardware/probe/out/3_Stirrup_Back.stl

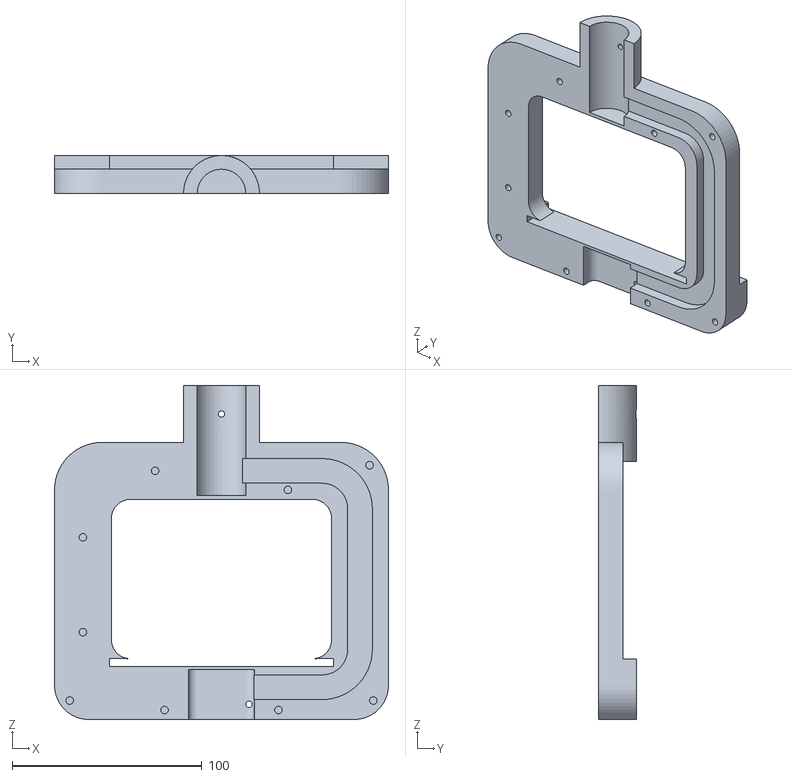
[picture p30: CAD file, 2026-11-07]
hardware/probe/out/3_Stirrup_Back.stl
176.0 x 20.0 x 176.0
