eroxa090/SoilPlus2.0/hardware/probe_mini/out/12_Electrode_Cap_Holder.stl

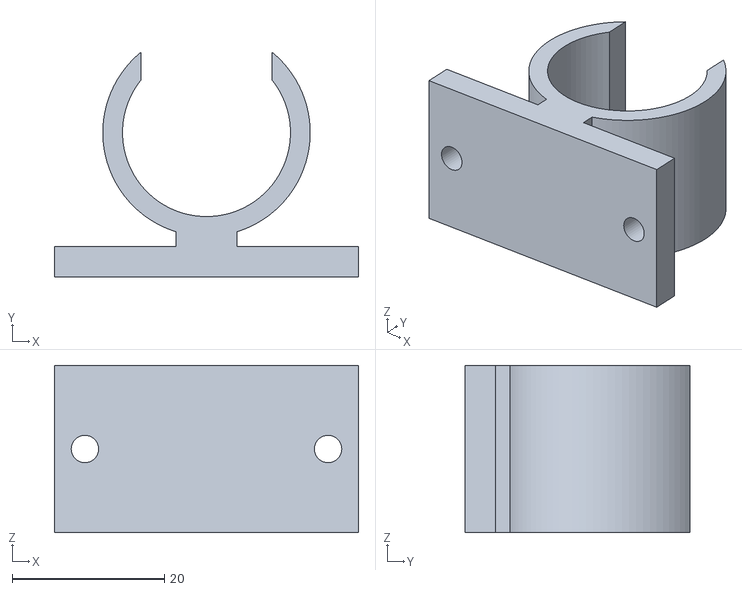
[picture p31: CAD file, 2026-11-12]
hardware/probe_mini/out/12_Electrode_Cap_Holder.stl
40.0 x 29.6 x 22.0
