eroxa090/SoilPlus2.0/hardware/probe/out/8_Mount_Plate.stl

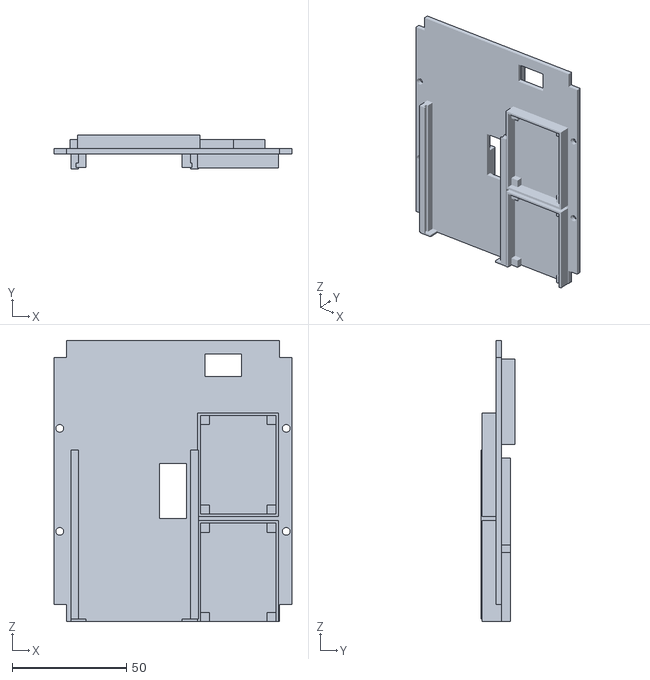
[picture p32: CAD file, 2026-11-07]
hardware/probe/out/8_Mount_Plate.stl
104.0 x 15.0 x 122.8
