eroxa090/SoilPlus2.0/hardware/probe_mini/out/13_Electrode_Clip.stl

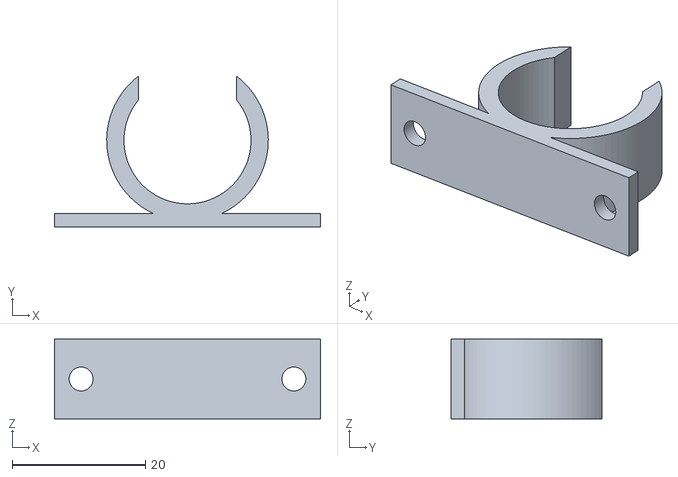
[picture p33: CAD file, 2026-11-12]
hardware/probe_mini/out/13_Electrode_Clip.stl
40.0 x 22.6 x 12.0
