eroxa090/SoilPlus2.0/hardware/probe_mini/out/11_DS_Guard.stl

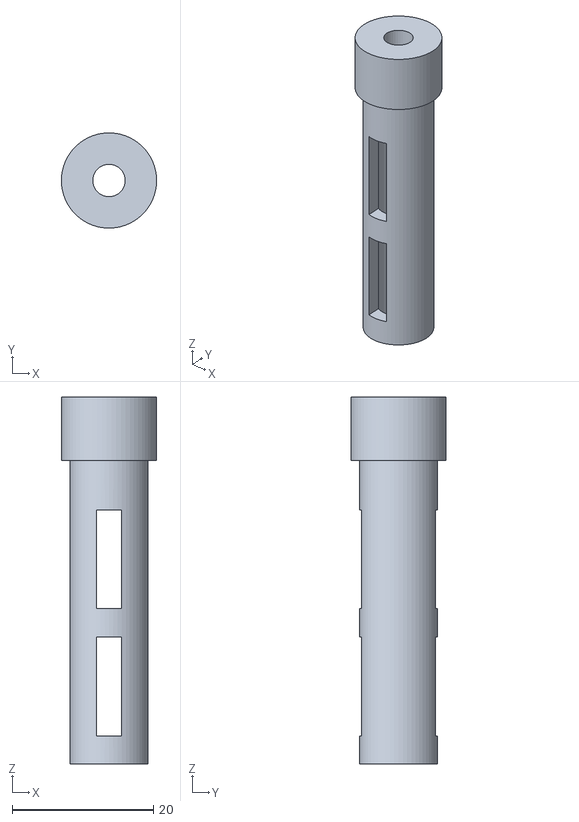
[picture p34: CAD file, 2026-11-12]
hardware/probe_mini/out/11_DS_Guard.stl
13.5 x 13.5 x 52.0
