eroxa090/SoilPlus2.0/hardware/probe_mini/out/6_Blade_Guard.stl

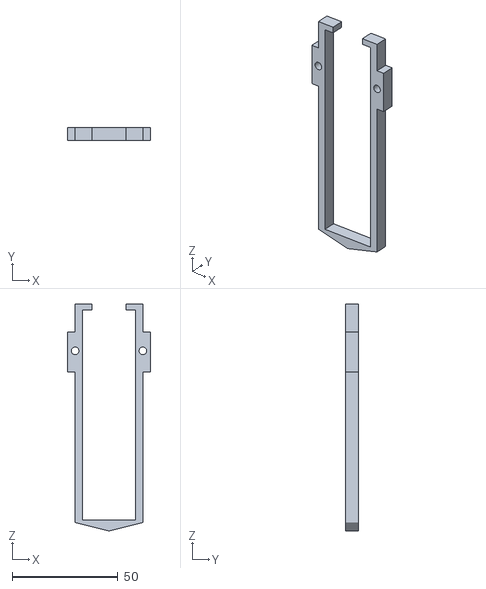
[picture p35: CAD file, 2026-11-12]
hardware/probe_mini/out/6_Blade_Guard.stl
39.2 x 6.00 x 107.1
