eroxa090/SoilPlus2.0/hardware/probe_mini/out/8c_Clamp_TDS.stl

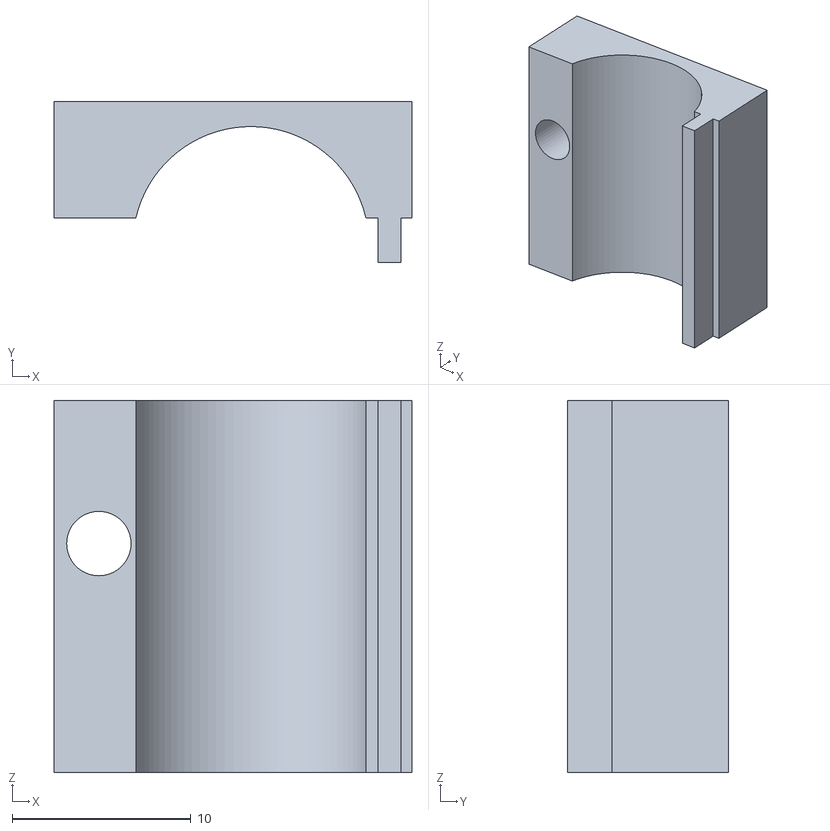
[picture p36: CAD file, 2026-11-12]
hardware/probe_mini/out/8c_Clamp_TDS.stl
20.0 x 9.00 x 20.8
