eroxa090/SoilPlus2.0/hardware/probe_mini/out/8a_Clamp_Center.stl

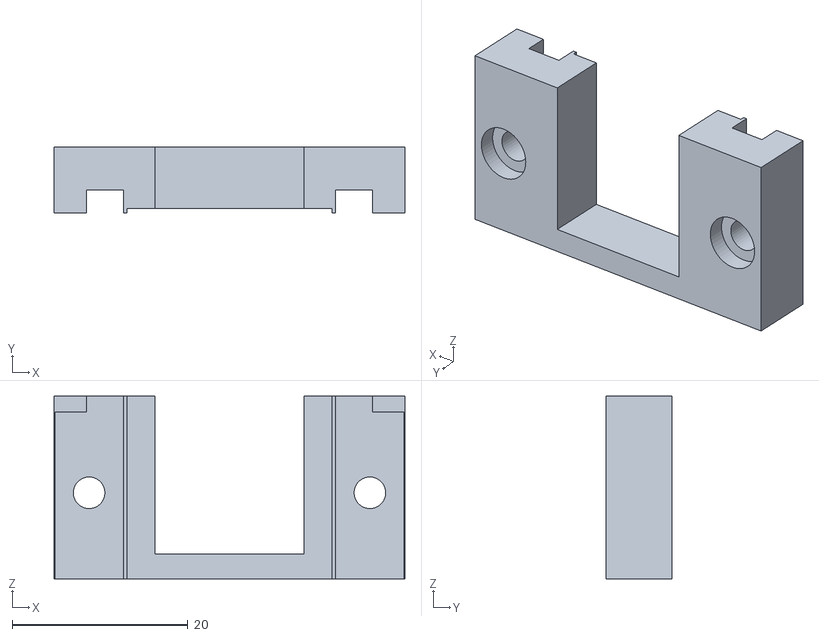
[picture p37: CAD file, 2026-11-12]
hardware/probe_mini/out/8a_Clamp_Center.stl
40.0 x 7.50 x 20.8
