eroxa090/SoilPlus2.0/hardware/probe_mini/out/2_Lid.stl

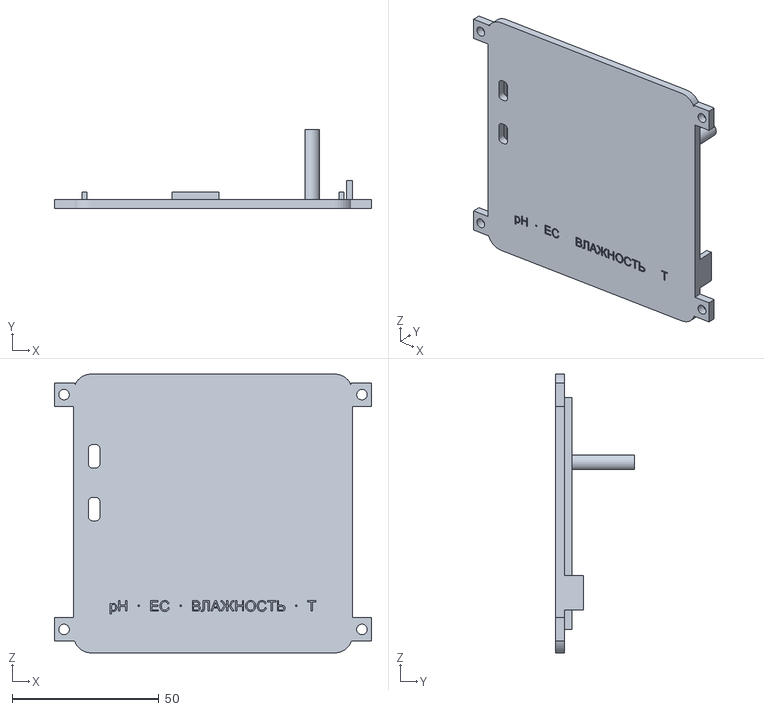
[picture p38: CAD file, 2026-11-12]
hardware/probe_mini/out/2_Lid.stl
108.0 x 26.9 x 95.0
