eroxa090/SoilPlus2.0/hardware/probe_mini/out/10_Back_Frame.stl

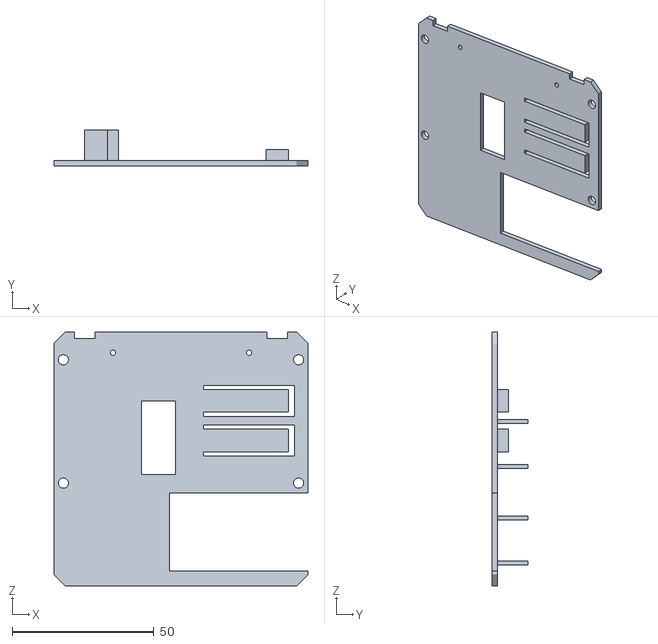
[picture p39: CAD file, 2026-11-12]
hardware/probe_mini/out/10_Back_Frame.stl
89.6 x 12.8 x 89.6
