eroxa090/SoilPlus2.0/hardware/probe_mini/out/16_Plug_TypeC_Charge.stl

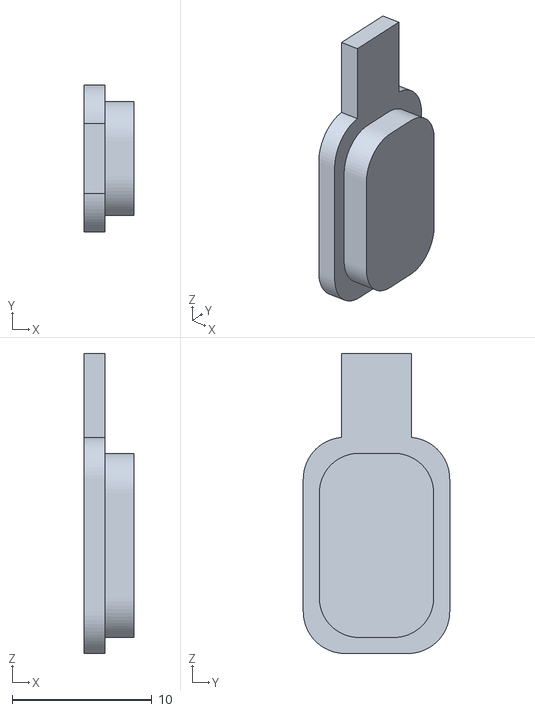
[picture p41: CAD file, 2026-11-12]
hardware/probe_mini/out/16_Plug_TypeC_Charge.stl
3.60 x 10.5 x 21.5
