eroxa090/SoilPlus2.0/(list of files, cad)

Other CAD files:
hardware/probe/out/6_Handle_Front.stl
