eroxa090/SoilPlus2.0/(commit log)

2026-04-27 Initial commit: SoilPlus 2.0
    IoT + AI precision-agriculture platform for Central Asian farms.
    Features:
    - ESP32-based soil probe (pH, EC, moisture, temperature)
    - AI agronomist chat (Gemini 2.5 Flash) in Russian/English
    - Photo plant disease diagnosis with species ID + treatment plan
    - Irrigation calculator: KazNIIZ formula + FAO-56 35 L/m² cap
    - Yield forecast with risks & boosters per crop
    - Device shop with admin order dashboard
    - PBKDF2 + HMAC session auth, first user becomes admin
    Made in Uralsk, Kazakhstan · 2026
    Co-founders: Sultan Bekkaliev & Ersultan Muratkali
2026-05-08 update device photo on shop page
2026-05-08 replace shop device photo
2026-09-24 Open device pages to visitors; add serial calibration to firmware
    Web:
    - middleware: /connect, /chat and /irrigation no longer require a login.
    None of the three touches Supabase — the device stream is a direct
    browser-to-ESP32 WebSocket and the calculators are pure functions — so
    the gate only cost us visitors bouncing at the login wall, and it broke
    the live device demo whenever the database was asleep.
    - next.config: pin outputFileTracingRoot so a stray parent lockfile can't
    shift the inferred workspace root.
    Firmware:
    - calibration (pH points, TDS factor, moisture endpoints) now lives in NVS
    and is edited over serial: cal ph7 | cal ph4 | cal tds <ppm> |
    cal moistdry |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
    [soilplus.ino]
2026-09-24 Drop the device-owner gate from /connect, /chat and /irrigation
    The middleware change alone did not open these pages: each route also
    wrapped its children in DeviceGate from its layout, a server component
    that calls getSessionUser() and redirects anonymous visitors to /login.
    So the pages stayed shut, and because that call hits the database they
    also died whenever the database was asleep.
    Removing the three layouts drops the last gate. The pages now prerender
    as static, since none of them reads the session any more; /dashboard
    keeps DeviceGate because it renders a specific owner's plots.
    Navbar: move the three routes into PUBLIC_LINKS so they stop rendering
    a padlock, and lead with the agr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
2026-10-24 Add CLAUDE.md: shared working rules for both laptops
    Two people now work on this repo from separate machines, each with their
    own Claude, and nothing written down kept them from overwriting each
    other. CLAUDE.md is read automatically when Claude Code starts in the
    project, so the rules reach the second laptop with a plain git pull.
    It covers the git workflow (own branch, pull --rebase first, no direct
    commits or force-push to main, stop and ask on conflicts, no whole-file
    reformatting) and the hardware facts we only learned by breaking things:
    the pin map, the 4095/0 symptom decoder, functional checks that go
    beyond "the value moves", TDS-to-pH interference, keeping calibration in
    NVS, and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
2026-10-24 Fix irrigation units; compute chat water volumes in code, not the model
    Irrigation overstated every norm about 4x. Crop optimum bands and the
    moisture reading are % of field capacity (% НВ, the standard agronomic
    notation — wheat 60–70 % НВ), but the formula fed that %-gap straight
    into ΔW × D × ρ, which needs a gravimetric deficit. Wheat at 18 % НВ came
    out at 395 L/m² — more than a year of rain in West Kazakhstan. ΔW is now
    multiplied by field capacity (default 0.24 kg/kg, loam), i.e. the
    Kostyakov norm: the same case gives 95 L/m² in 3 waterings, and a typical
    45 % НВ gives 40 L/m² in 2.
    The chat sent Gemini only the formula and let it do the arithmetic, so
    every li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
2026-10-24 Take crop salinity thresholds from FAO instead of unsourced guesses
    The EC_max values disagreed with FAO salt-tolerance data in both
    directions and even in ordering: alfalfa (FAO: moderately sensitive,
    2.0 dS/m) had a higher ceiling than wheat (moderately tolerant, 6.0).
    Barley, cotton and wheat were set 2-2.7x too strict, so ordinary soil
    triggered the 1.3x flushing coefficient; corn, potato and alfalfa were
    ~2x too lenient, so harmful salinity passed silently.
    Each threshold is now FAO's ECe at 100 % yield (Irrigation and Drainage
    Paper 29 Rev.1, Table 4; Paper 61, Annex 1), converted to the probe's
    unit: 1 dS/m = 1000 µS/cm -> 500 ppm, matching the firmware's 0.5 factor.
    Apple has an FA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
2026-10-24 Move Wi-Fi credentials out of the firmware into gitignored secrets.h
    The hotspot password sat in soilplus.ino, i.e. in a public repository.
    SSID and password now come from firmware/soilplus/secrets.h, which git
    ignores; secrets.example.h is the committed template. The compiled image
    is byte-for-byte the same size (788 321 bytes), so the board does not
    need reflashing. The old password remains in the first commit's history;
    rewriting main's history would break both clones, so the remedy is to
    change the hotspot password at the next reflash.
    The Wi-Fi comment also said to turn OFF "Maximize Compatibility" on
    iPhone. It must be ON — that setting is what forces the hotspot onto
    2.4 GHz, the o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
2026-10-24 Let the firmware join any of up to three known hotspots
    The board knew exactly one SSID, so the device only worked next to the
    phone whose hotspot was compiled in. With the demo run by whichever team
    member is on site, that meant renaming phones or reflashing per person.
    It now uses WiFiMulti: secrets.h lists up to three networks
    (SOILPLUS_WIFI_SSID, _2, _3) and the board joins the strongest known one
    in range. The reconnect path in loop() uses the same list, so a phone
    switched on after boot is still picked up — at the cost of a ~2-3 s scan
    every 30 s, and only while offline. Serial now prints which network it
    joined. Credentials stay in the gitignored secrets.h; secrets.example.h
    shows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
2026-10-24 Add password recovery: email a one-hour, single-use reset link
    There was no way back into an account after a forgotten password — the
    only option was a new signup. Login now links to /forgot-password; it
    emails a link to /reset-password, where the user sets a new password and
    is signed straight in.
    The reset token needs no database table. It is HMAC-signed with a key
    derived from SESSION_SECRET for this purpose only (so it can never pass
    as a session cookie), expires after an hour, and embeds a fingerprint of
    the current password hash: once the password changes, every outstanding
    link stops verifying, which makes each link single-use without storing
    anything.
    /api/auth/forgot answers ide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
2026-10-26 Fix the mirrored pH scale; stop TDS and moisture failing on bad input
    pH: computePH divided by (V7 − V4) instead of (V4 − V7), so the two-point
    line was mirrored around 7 — the pH 4 buffer read 10, pH 8.5 read 5.5.
    Every calibration so far was done at the neutral point, where the error is
    zero, which is why it went unnoticed. It also inverted the agronomy: acidic
    soil was flagged alkaline and the advice swapped lime for sulfur. Fixed
    in the firmware, which now also broadcasts "fw": 2.
    The board in the field still runs the old build and reflashing it means
    unplugging every sensor, so the site undoes the error on its side: the
    mirror is exact (true pH = 14 − sent pH), and useSoilSocke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
2026-10-27 Smooth the live pH and TDS with a 5-second rolling median
    The high-impedance pH probe plus Wi-Fi noise on the ESP32 ADC made a
    probe sitting still jump ±0.2 pH between broadcasts, and TDS jittered
    the same way. A median of the last 25 readings (5 s at 5 Hz) keeps pH
    within ±0.04 and TDS within a few ppm. Site-only; no firmware change.
2026-11-07 Add handheld probe enclosure: Fusion script, print files, wiring
    hardware/probe: Fusion Python script that builds the handheld soil probe
    (T-handle, 25 mm tube shaft, electronics head with removable mount plate,
    stirrup, sensor nose), checks interference and exports STEP/STL. out/ holds
    the result of a clean run (0 build errors, 0 clashes) plus a fit-test part.
    hardware/enclosure: earlier stake-style case (build123d), kept for reference.
    hardware/wiring.md: pin-by-pin wiring table for Cirkit Designer / Wokwi.
2026-11-12 Replace the long probe with SoilPlus Mini enclosure; drop the pump wiring
    hardware/probe_mini: Fusion script for the short handheld probe (body with
    two-tier mount, lid, deck and back frame, wide-base T-handle, sensor head
    with three-piece sensor clamp, blade guard, DS18B20 guard, pH electrode
    holders, cap, Type-C plugs). All fits use 0.3 mm clearance; measured part
    sizes are parameters at the top. out/ holds the last clean Fusion run
    (0 build errors, 0 interferences) and a fit-test part.
    hardware/wiring.md: wiring for the Mini without pump, flow meter or MOSFET,
    plus the new Cirkit Designer link.
    Removed hardware/probe (long probe) and hardware/enclosure (stake case);
    both are superseded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
2026-11-12 Mini probe: screw M3 straight into plastic, 1.8 mm board slots
    No brass inserts on hand, so the 4.0 mm insert holes become 2.5 mm
    pilot holes. The test print fit the perfboard snugly at 1.7 mm. The
    deck slots lie across the layers, so they are 1.8 mm (nine 0.2 mm layers).
